GabrielMastny/Skoda_2021MUFUSteeringWheel_Converter/README.md

<p align="center">
  <b>Škoda převodník 2021 MUFU volantu - Škoda 2021 MUFU steeringwheel converter</b>
</p> 

tested on/testováno na:
 - Fabia III 2015
 - Octavia III 2017
 - Superb III 

<p align="center">
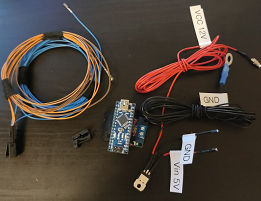
[picture p1: Images/CConverter.png]
  
</p> 

<p align="center">
  <a href="https://github.com/GabrielMastny/Skoda_2021MUFUSteeringWheel_Converter/blob/main/README.cz.md">
         
    <br>
  Přejít na návod v češtině
      </a>
  
</p>  

<p align="center">
  <a href="https://github.com/GabrielMastny/Skoda_2021MUFUSteeringWheel_Converter/blob/main/README.en.md">
         
  <br>
  Go to English how-to
      </a>
</p>
