GabrielMastny/Skoda_2021MUFUSteeringWheel_Converter/Images/IMG_20220803_100342.jpg

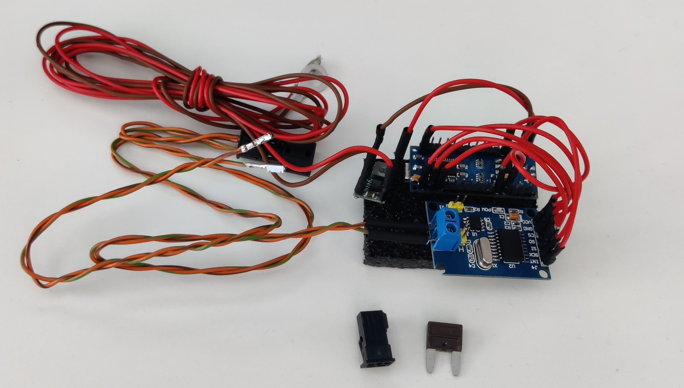
Images/IMG_20220803_100342.jpg
