GabrielMastny/Skoda_2021MUFUSteeringWheel_Converter/(commit log)

2022-06-19 Update README.cz.md
    updated some errors and one new row to table on behalf of Wirer.
2022-06-19 Update README.en.md
    fixed few errors and added new row to table on behalf of Wirer
2022-06-21 fixed copypaste bug
    user defined buttons now will work correctly
    [CAN_Converter_MUFU_Skoda.ino]
